exploration/compliment-bot/arduino/compliment-bot-arduino-attiny85/readme.markdown

# Compliment Bot

The Arduino sketch controls the blinky lights for compliment bot. This version is designed to run from the much smaller, more economical [attiny85](https://www.sparkfun.com/products/9378) microcontroller board. It's basically the same setup with slightly different wiring.
