exploration/compliment-bot/arduino/compliment-bot-arduino/readme.markdown

# Compliment Bot

The Arduino sketch controls the blinky lights for compliment bot
