exploration/compliment-bot/(list of files, drawings)

Other design files:
help/wiring-diagrams/compliment-bot-wiring-arduino.fzz
help/wiring-diagrams/compliment-bot-wiring-trinket.fzz
