exploration/compliment-bot/help/wiring-diagrams/compliment-bot-wiring-arduino_bb.png

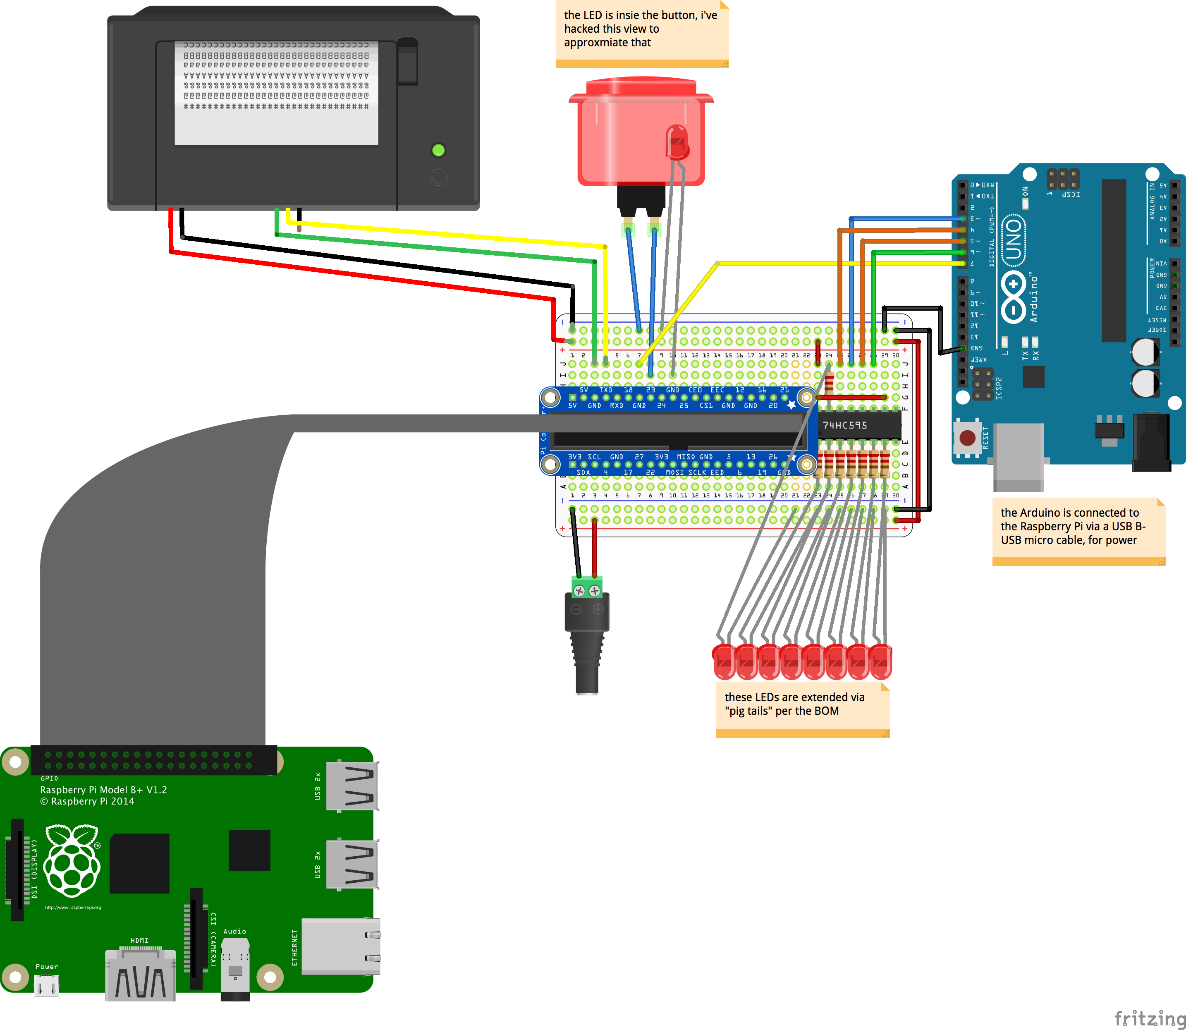
help/wiring-diagrams/compliment-bot-wiring-arduino_bb.png
