exploration/compliment-bot/(commit log)

2014-11-11 added wiring diagrams
    [compliment-bot-wiring.fzz]
2014-11-13 added markdown version of BOM in case teh Google goes down
2014-11-13 moved files + added TSV version of BOM
    [compliment-bot-bom.tsv, compliment-bot-wiring.fzz]
2015-05-18 update wiring diagram to include PWM
    [compliment-bot-wiring.fzz]
2015-05-18 move arduino sketches into subfolder
2015-05-18 clean up quoting
    [compliment-bot-bom.tsv]
2015-05-18 more quote cleanup
    [compliment-bot-bom.tsv]
2015-06-01 update code to allow keyboard interrupt
2015-06-04 Update diagram
    [compliment-bot-bom.tsv, compliment-bot-wiring-arduino.fzz]
2015-06-04 Add trinket wiring diagram
    [compliment-bot-wiring-trinket.fzz]
2015-06-04 update with trinket pricing options
    [compliment-bot-bom.tsv]
2015-06-04 fix wiring diagrams to repair broken cobbler reference
    [compliment-bot-wiring-arduino.fzz, compliment-bot-wiring-trinket.fzz]
2017-08-03 only do one newline after print
2017-08-03 only print one newline afterward
2017-08-03 minor print adjustments
